AttilaTheHunBruce/Ferd/Balloon Project Plan.odt

# Summary

- I wanted to mate a solar-powered WSPR transmitter with a bunch of helium party balloons (balloon). The idea is to have the balloon report its position and status over WSPR via radio transmission. Amateur radio operators monitor WSPR and report any WSPR transmissions they receive to a central database. I can query the database over the Internet and have a record of the balloon’s progress. I have visions of grandeur and can picture the balloon traveling great distances. Joel suggested the name Magellan. I like that; seems quite appropriate. My wife suggested shortening the name to something a bit more cryptic, so I’m currently referring to the project as Ferd after Ferdinand Magellan.
- Ferd is an attempt to create an inexpensive balloon/payload/antenna system capable of being tracked over long distances. The idea is to use a balloon to carry a transmitter sending out a Weak Signal Propagation Reporter (WSPR) signal. The transmitter is computer controlled and powered by a small solar panel. The antenna is an offcenter-fed antenna hanging from the balloon cluster above the transmitter.
- The transmitter power level will be somewhere between 100 mW – 200 mW. This should be capable of being received thousands of miles away under normal band conditions, so Ferd should be trackable anywhere in the world.
- The total package should weigh less than 3 ounces and cost less than $100 to make, not including the cost of the balloons.
- I want to make the hardware and software opensource. I like the Microsoft Public License (https://opensource.org/license/MS-PL) for software and the TAPR Open Hardware License (https://www.tapr.org/ohl.html) for hardware.
- Ferd should be user-friendly, meaning no surface mount parts and a relatively straightforward programming environment. I’m currently planning on using an Arduino. The Arduino development environment was designed to be as unpainful as practical.
- There are a range of parameters that I’d like to explore. For example, choice of frequency to transmit on, choice of gas to use in the balloon(s), and what altitude to aim for. This will require multiple launches.
- I would like to have units available for sale at Hamvention 2018. The project will have to be presented and approved by the TAPR board meeting at the DCC in September 2017, so the development work and hopefully a flight should be complete by then.
- I intend to use this document as a sort of catchall to record design and operational information so I can find it later.

# Objectives

- I am interested in doing the project for my own enlightenment and to satisfy my curiosity. In addition, I think it would be an interesting and informative project for my friends to take part (not to mention that there’s a lot of work and I can definitely use the help).
- A developed version of Ferd could be marketable by Tuscon Amateur Packet Radio (TAPR). I am a member of TAPR and willing to turn the design over to them for that purpose. TAPR has also offered to cover the cost of materials used in the development effort.
- I can envision schools and groups like scouts being interested in launching and tracking a low cost balloon. I intend to try make the project buildable by people with limited computer and electronic skills, but make no promises as to how low we can go.

73 Bruce Raymond/ND8I

# Design

- WSPR transmitter on 30m
- GPS for location, altitude, and time
- ~200 mW output
- off center-fed antenna
- telemetry: grid square, refinement of grid square, altitude, velocity, temperature, power supply voltage, transmitter output power
- lifted by multiple mylar party balloons;
- cruising altitude of 20,000 ft and stay aloft for several weeks under ideal conditions

## Frequencies

Band (Mtr) | Dial Frequency (MHz) | Lower Band Pass Frequency (MHz) | Upper Band Pass Frequency (MHz) | Band Width (Hz)
33400m | 0.0072 | 0.0087 | 0.0089 | 200
2200m | 0.1360 | 0.1374 | 0.1376 | 200
600m | 0.4742 | 0.4756 | 0.4758 | 200
160m | 1.8366 | 1.8380 | 1.8382 | 200
80m | 3.5926 | 3.5940 | 3.5942 | 200
60m | 5.2872 | 5.2886 | 5.2888 | 200
40m | 7.0386 | 7.0400 | 7.0402 | 200
30m | 10.1387 | 10.1401 | 10.1403 | 200
20m | 14.0956 | 14.0970 | 14.0972 | 200
17m | 18.1046 | 18.1060 | 18.1062 | 200
15m | 21.0946 | 21.0960 | 21.0962 | 200
12m | 24.9246 | 24.9260 | 24.9262 | 200
10m | 28.1246 | 28.1260 | 28.1262 | 200
6m | 50.2930 | 50.2944 | 50.2946 | 200
4m | 70.0910 | 70.0924 | 70.0926 | 200
2m | 144.4885 | 144.4899 | 144.4901 | 200

Channel bandwidth used is 6 Hz and the transmission time is 110.6 sec. The length of a single tone is 0,6827 s and maximum allowed drift is about 1 Hz.

## Antenna Design/Optimization

Ron Thomas and Bill Dionne have made antenna suggestions and calcs that I’d like to acknowledge. Based upon their inputs, The final antenna design is an off-center fed dipole. Well, it’s fed really off center. The overall antenna is 11.065 meters (36’-4”) long with the feed point at 2 meters (6’-7”) from the end, so it’s fed about 1/5 of the way from the end. This means the long leg is 29’-9” long and the short leg is 6’-7” long. The two legs are fed through a common mode choke (FT37-43: 5 turns). There is a 12 uH loading coil between the two legs (across the antenna feed).

This arrangement gives us a resistance of 50 ohms and a inductive reactance of 0.2 ohms for an SWR of 1.0:1. There are a number of combinations of lengths and feedpoint positions that will give us 50 ohms. The 3 dB bandwidth is 244 Khz. The thought was that we could tune out the reactance. What bothered me was that it appears that the tuning is very critical, so if the inductor value is off, the SWR rises quickly. This problem is more acute with higher reactance values (small percentage change in inductance yields a large change in reactance). Consequently, I chose a design that had relatively lower reactance to minimize this effect.

Note that the model/calculation assumes that the balloon is well up in the air so that there aren’t any ground effects affecting the antenna characteristics. The model showed substantially different characteristics when the antenna is closer to the ground (say, 30 ft).

Previous Design

End-fed dipole; FT37-43 toroid 24 turns:3 turns to transform 50 ohms to 3200 ohms

Antenna 44”-9”

Transmission Line 20” RG-174 with plastic outer casing removed

resonant at 10.180 MHz SWR = 1.10:1 Z = 55.3 ohms X = j 0.7 ohms

at 10.140 MHz SWR = 1.13:1 Z = 55.5 ohms X = j 3.4 ohms

### Final Antenna Design

As it turns out, Joel, Ray, and I played with the antenna in Ray’s backyard using Joel’s AA-54 antenna analyzer. The final design ended up being 30’ long, total. The long section is 25’-7”. The short section is 4’3”. This was done with the top of the antenna at about 35’ and the bottom at 5’. We couldn’t go any higher because I couldn’t convince Joel to hand from a rope in the tree at 40’. What a spoil sport. I also got rid of the common mode choke.

## Power/Solar Panel Design

Packaged solar panel vs combining multiple fragile solar cells – pick robust, packaged solar panel

Solar Panel: 6 V/1 W, weight ~23 g, 110 x 60 x 2.5 mm

## Hardware

The hardware consists of a payload and support infrastructure.

### Payload

The payload consists of:

- Main Assembly consists of carriage board, Arduino ProMini/3.3 volt, Adafruit Si5351 oscillator board, uBlox GPS board.
  The LED on the Arduino is on when transmitting.
  Carriage board contains amplifier (BS-170) and seven pole low pass filter, voltage regulator, and MOSFET(s) switch to turn on/off GPS board power.
  A future version of the electronics could be done with surface mount parts and automated assembly. This would simplify soldering part of the kit building to just connecting the three circuit boards plus any components that can’t be surface mount, for whatever reason. This option would require producing a significant quantity of kits to be economically feasible.
- Solar Panel

The solar panel is a monolithic unit with + and – connections on its underside. These connections provide power to the main assembly through a pair of wires. The wires are longer than necessary for a short path connection to help with fatigue resistance from relative movement between the solar panel and the main assembly from vibration and thermal expansion.

- Antenna is offcenter-fed.

### Support Infrastructure

The support infrastructure is the connections between the balloons and the payload along with the internal payload connections (attaching the solar panel to the rest of the payload).

## Software

### Initialization

- Open serial port and second serial port (to talk to GPS).
- Instantiate wspr object for controlling RF chain.
- Setup Timer0 for timing (currently unused).
- Setup Timer1 to count timer overflows.
- Setup the External Interrupt (INT0) to capture the 1 PPS signal from the GPS.
- Initial variables.

### Time Synchronization

The second channel of the TXCO/PLL is configured to generate a 1 MHz signal that is fed into Timer1. Timer1 overflows every 1,000 counts, giving a fairly accurate 1 ms clock interrupt. A counter is incremented inside of the interrupt handler and used to control timing events to within a few milliseconds.

The 1 PPS output from the GPS is connected to the INT0 interrupt. This is used to signal the beginning of a one second interval. This signal is used in conjunction with the time (HH:MM:SS) data from the GPS to accurately set the internal clock/counter.

There is an issue with using the GPS and PLL at the same time. The PLL output appears to swamp the input of the GPS. Also, the GPS draws ~70 mA on startup. There isn’t enough current capacity from the solar panel to drive both the GPS and transmitter simultaneously. Therefore, the PLL (which drives the transmitter) is turned off while the GPS is running and the GPS is turned off while the transmitter is running. The Arduino Pro-Mini internal clock is used to maintain the time during the transition between when the GPS is turned off and the PLL is turned on.

### Telemetry Data

Data are collected from the GPS at the beginning of the cycle. After that the GPS is turned off for the remainder of the cycle, so there is no opportunity to refresh the data during the cycle. Internal measurements (bus voltage and temperature) are made at this time. Transmitter output power can’t be measured yet because the transmitter hasn’t been turned on.

There are four WSPR cycles following turning the GPS off. The first is a regular WSPR transmission (call sign, grid square, power level). The second is a bogus WSPR transmission with the telemetry data formatted into a WSPR message. The callsign starts with the letter Q, making it an invalid callsign so as not to be confused with a legitimate callsign. The third transmission is a repeat of the first and the fourth transmission is a repeat of the second.

After the four WSPR transmissions the GPS is restarted and the process repeats.

The transmitter output is measured ¼ th of the way through the first transmission. ¼ was selected so that the transmitter output could stabilize (if necessary).

The Arduino LED is turned on when transmitting.

### State Machine

- Turn on GPS, wait for GPS lock. (state= StartGPS)
- Calibrate clock, turn GPS off, encode WSPR data. (state = WaitingForSatelliteLock)
- Transmit WSPR message (state = Transmittion1)
- Transmit alternate message (state = Transmittion2)
- Transmit WSPR message (state = Transmittion3)
- Transmit alternate message (state = Transmittion4)

### Power

- Solar panel puts out about roughly 5 volts at 130 mA
- Arduino Pro Mini uses an Atmel ATmega328P processor. Maximum current draw is 9 mA
- Adafruit Si5351 board draws 15 mA
- uBlox GPS module draws 47 mA
- Power amplifier draws 100 mA (5 volts/ 50 ohms)

Two operating states:

- Arduino, Si5351, GPS => 9 mA + 15 mA + 47 mA = 71 mA
- Arduino, Si5351, Power Amplifier => 9 mA + 15 mA + 100 mA = 124 mA

# Testing

## Test Plan/Procedures

## Temperature Testing

Cold soak payload unit to assess how well it works in cold temperatures

Cold soak solar panel and verify that it still works when cold

use dry ice for cold soaking

## Functional Testing

Individual function tests

## Endurance Testing (day/night)

Combined system test – hang solar panel/transmitter/antenna from tree and verify that unit starts up and transmits as expected over a period of several days

## Weight Tradeoffs

I’m always trying to make the payload lighter. There are some practical limits. The balloons weight 0.56 oz/each. The weight of the three circuit boards (Arduino, GPS, PLL) are fixed. I could use a smaller solar panel (I have one that is about 75% the size of my current solar panel), but I’m worried about not having enough power in cloudy conditions. There are probably diminishing returns for much more extensive weight cutting. The payload is currently somewhere around 2 oz.

# Launch

## Balloon Management

Gas selection (hydrogen vs helium)

rent vs buy for regulators and tanks

filling process

filling calculations – design maximum height

what kind of balloons to get

where to get balloons

## Launch Procedures & Checklists

Test port on uC for preflight functional testing (serial communications through microUSB port to a laptop)

## Launch Schedule

# Tracking

Monitoring WSPR site (http://wsprnet.org/drupal/wsprnet/map).

Downloading data.

Interpreting data.

Recording data.

Message Structure:
$GPGGA,hhmmss.ss,Latitude,N,Longitude,E,FS,NoSV,HDOP,msl,m,Altref,m,

DiffAge,DiffStation*cs<CR><LF>
Example:
$GPGGA,092725.00,4717.11399,N,00833.91590,E,1,8,1.01,499.6,M,48.0,M,,0*5B

Field No. | Example | Format | Name | Unit | Description
0 | $GPGGA | string | $GPGGA | - | Message ID, GGA protocol header
1 | 092725.00 | hhmmss.sss | hhmmss. ss | - | UTC Time, Current time
2 | 4717.11399 | ddmm.mmmm | Latitude | - | Latitude, Degrees + minutes, see Format description
3 | N | character | N | - | N/S Indicator, N=north or S=south
4 | 00833.91590 | dddmm. mmmm | Longitud e | - | Longitude, Degrees + minutes, see Format description
5 | E | character | E | - | E/W indicator, E=east or W=west
6 | 1 | digit | FS | - | Position Fix Status Indicator, See Table below and Position Fix Flags description
7 | 8 | numeric | NoSV | - | Satellites Used, Range 0 to 12
8 | 1.01 | numeric | HDOP | - | HDOP, Horizontal Dilution of Precision
9 | 499.6 | numeric | msl | m | MSL Altitude
10 | M | character | uMsl | - | Units, Meters (fixed field)
11 | 48.0 | numeric | Altref | m | Geoid Separation
12 | M | character | uSep | - | Units, Meters (fixed field)
13 | - | numeric | DiffAge | s | Age of Differential Corrections, Blank (Null) fields when DGPS is not used
14 | 0 | numeric | DiffStat ion | - | Diff. Reference Station ID
15 | *5B | hexadecimal | cs | - | Checksum
16 | - | character | <CR><LF> | - | Carriage Return and Line Feed

Message | VTG
Description | Course over ground and Ground speed
Type | Output Message
Comment | Velocity is given as Course over Ground (COG) and Speed over Ground (SOG).
ID for CFG-MSG | Number of fields | Message Info
0xF0 0x05 | 12

Message Structure:
$GPVTG,cogt,T,cogm,M,sog,N,kph,K,mode*cs<CR><LF>
Example:
$GPVTG,77.52,T,,M,0.004,N,0.008,K,A*06

## Telemetry

### Data Encoding

The data stream consists of two WSPR messages. The first is a standard WSPR message with call sign, grid square, and power level (dBm). The second encodes the additional data carries 5th and 6th Maidenhead locator characters, altitude, speed, power bus voltage, temperature, transmitter output power. The second message type will show up in the database as callsigns whose 1st character is "Q" and 3rd character is "5". The other characters and locator and power contain the encoded data, not a valid location.

Telemetry is embedded into the second message. A WSPR data string contains a) call sign, b) grid square, c) power level (dBm). The second message is encoded as follows:

Altitude is encoded as two characters (altitude1 and altitude2). Velocity is encoded as two characters (velocity1 and velocity2). Temperature and bus voltage are stored in one character. Transmitter power (transmitPower) is a single variable spread across two characters in the message.

Second message format is shown below:

### Data Decoding

callsign is made up of 6 characters => c1 c2 c3 c4 c5 c6

gridsquare is made up of 4 characters => g1 g2 g3 g4

power is made up of 2 characters => p1 p2

Alpha characters are converted to numeric values by subtracting 65 (0x40, or A) from the ASCII value, so that A=0, B=1, C=2, etc. Alpha versions of numeric values are are converted to numeric by subtracting 48 (0x30, or 0). This is a straightforward substitution if done manually. Once this is done, the telemetry data are extracted as follows:

altitude = 1750 * g1 + 50 * c2

e.g.: g1=F, c2=R => altitude = 1750 * 5 + 50 * 17 = 9,600 ft

velocity = 10 * g3 + g4

e.g.: g3=5, g4=9 => velocity = 10 * 5 + 9 = 59 Km/hr

temperature = 5 * c4 – 30

e.g.: c4 = D => temperature = 5 * 4 – 30 => temperature = -10 degC

bus voltage = g2 / 4 + 3

e.g.: g2=M => bus voltage = 12 / 4 + 3 => bus voltage = 6.0 volts

power = 10 * p1 + p2 => yields

e.g.: p1=3, p2=7 => power level = 0.16 watts (see below)

The reader is cautioned to take this number with several large grains of salt. There are a lot of factors that can affect the validity of the reading. The telemetry power level should probably only be used as a relative measurement (“Our range just seems to have dropped. I wonder if the transmit power has dropped?”).

### Altitude

From GPS.

### Velocity

From GPS.

### Temperature

I’m using a thermistor I bought from DigiKey years ago. Its parameters are:

B0 = 3,977 ohms, R0 = 10,000 ohms, T0 = 298 degC, NTC

The thermistor is in a voltage divider circuit with an 8,200 ohm resistor feeding it from a 3.3 volt supply. The output of the voltage divider is fed into a 10-bit A/D converter with a 3.3 volt reference. The output from the A/D converter is converted to resistance as follows -

A/D output goes from 0 – 1023 counts: v = A/D counts * (3.3 volts / 1023 counts)

v = R * 3.3 volts / (R + 8,200 ohms) = 3.3 volts / 1023 counts

rearranging

R = 8,200 * A/D / (1023 – A/D)

Converting from resistance (R) into temperature using a rearranged Steinhart-Hart equation is of the form -

T = B0 / ln( R / (R0 * exp( -B0 / T0 ) ) ) = 3977 / ln( R / (10,000 * exp( -3977 / 298 )))

= 3977 / (4.315 + ln( R ))

### Power Supply Voltage

The bus voltage is fed to an A/D converter channel after running through a voltage divider (8.2K for both resistors). The output voltage is V / 2. This is converted into counts (A/D numbers) by multiplying by 1023 (full scale counts) and dividing by 3.3 volts (reference). IOW -

V = (Vbus / 2)

A/D = V * 1023 counts / 3.3 volts => V = A/D * 3.3 / 1023

combining -

Vbus = (2 * V) = 2 * A/D * 3.3 / 1023 = 6.4516E-3 * A/D

I noticed that my voltage reading were low by about 4.1%, so I added a fudge factor/multiplier (1.041) to compensate.

### Solar Cell Calculations

6V/1W solar cell => Voc = 6 volt, Isc = 1W / 6V = 166 mA

Vmp = 0.75 * Voc = 0.75 * 6 = 4.5 volts

Imp = 0.85 * Isc = 0.85 * 166 mA = 141 mA

Maximum power = Vmp * Imp = 4.5 volts * 141 mA = 634 mW

# Other

## TAPR Considerations

What extra needs to be done to make a kit sellable by TAPR?

Who puts the kits together?

Can we have the boards stuffed in China and then the kit builder only attaches the Arduino, PLL, and GPS boards?

# Legal & Regulatory Issues

## FCC Issues – Is transmitting on 30m legal?

It is legal to operate an automatic transmitter on 30m in a digital mode. Part 97.221(b) specifically authorizes an automatically controlled digital station transmitting on the packet/data segment of the 30m band. Part 97.221(c)(1) requires that the station be responding to local or remote control. The on-board microcontroller is our proxy for local control. It monitors conditions and transmitter inputs and shuts down the transmitter if transmitting would be problematic. Note that the final amplifier can only generate 360 mW (V²/2Po) at most.

§97.221 Automatically controlled digital station.

(b) A station may be automatically controlled while transmitting a RTTY or data emission on the 6 m or shorter wavelength bands, and on the 28.120-28.189 MHz, 24.925-24.930 MHz, 21.090-21.100 MHz, 18.105-18.110 MHz, 14.0950-14.0995 MHz, 14.1005-14.112 MHz, 10.140-10.150 MHz, 7.100-7.105 MHz, or 3.585-3.600 MHz segments.

(c) Except for channels specified in §97.303(h), a station may be automatically controlled while transmitting a RTTY or data emission on any other frequency authorized for such emission types provided that:

(1) The station is responding to interrogation by a station under local or remote control;

## FAA Issues

Our payload is under 6 lbs, so technically we do not have to comply with any other parts of Part 101 by virtue of subsection § 101.1(a)(4).

That said, we should notify the FAA/local ATC of our intentions and get guidance as to what notifications (e.g. NOTAMS) are useful.

### Liability

Our/my liability?

TAPR liability?

### Hazard Matrix

Hazard Matrix

How do other balloons and beacons handle this?

What happens if the balloon travels into another country’s air space?

### Hazards

- Line supporting payload breaks. Low probability. We have multiple balloons and supporting tethers so that a failure of one or several balloons or tethers will not cause a catastrophic drop of the payload. The net result of a balloon failure will be a controlled descent. A failure of one or more tethers will also be a controlled descent.
- Balloon/Payload sucked into airplane engine. This is a concern, although the probability of it happening is very low. The mitigation is to notify FAA/ATC of flight plans and issue a NOTAMS. The payload is well under the FAA weight limit for taking precautions (4 oz vs 6 lbs). The smallest weight listed for bird strikes appears to be 0.85 Kg (1.87 lbs), which is at least seven times heavier than the payload (https://www.skybrary.aero/index.php/Aircraft_Certification_for_Bird_Strike_Risk).
- Hydrogen catches fire during or after inflating balloons. The probability of this happening is low as long as proper storage and inflation procedures are followed. We’ll use helium for the initial launches.
- Complaints from owner of launch site. Make sure we have permission to launch from any private property.
- Someone gets injured during launch. Create and follow launch procedures.

# Appendix A – Lift Analysis

# Ideal Gas Law

The basic calculations are formulated around the Ideal Gas Law –

P * V = n * R * T

where -

P = pressure

V = volume

n = number of moles of gas in the balloon

R = universal gas constant

T = absolute temperature

The Ideal Gas Law can be rearranged as follows -

P * V / T = n * R

R and n will remain constant because we’re assuming that there is no leakage from the balloon. Therefore, P * V / T will be constant at any altitude:

P1 * V1 / T1 = P2 * V2 / T2

The starting volume (how much gas we fill the balloon with on the ground) of gas can be derived by rearranging:

V1 = P2 * V2 * T1 / ( P1 * T2 ) (1)

# Conditions

- The airspace between 15,000 ft – 25,000 ft is potentially less used than the airspace below 10,000 ft and above 25,000 ft. This would seem to be a good target range to fly in. I chose 15,000 ft at a target altitude. Actually, this is the altitude where the gas inside of the balloon has expanded to the full volume of the balloon.
- A balloon will stop rising when it reaches equilibrium, IOW when the lift equals the weight supported. For our purposes, I’ll assume that we’re using seven 17” cube balloons (2 ft^3) and our payload is 2.5 oz, not counting the weight of the balloons or the weight of the helium/gas.
- The helium mixture available from balloon stores is 80% helium and 20% air. I’m just going to assume that its density is 31% of air.
  Atmosphere is 80% N2 and 20% O2, so average molecular weight = 80% * 2 * 14 (N2) + 20% * 2 * 16 (O2) = 28.8. Molecular weight of helium = 4. Average weight = 80% * 4 (He) + 20% * 28.8 (air) = 8.96, or 8.96 / 28.8= 31% of the weight of air.

# Balloon

The balloon will be partially filled upon launch, so that as it rises and the air gets thinner it will eventually fill completely at some altitude (fill altitude). I’ve selected the fill altitude as 15,000 ft.

I fit the Standard Air Data to second order polynomials to make interpolation easier. The polynomial coefficients are shown at the end of the section. In particular, the pressure, temperature, and density numbers were arrived at using these polynomials. The values aren’t shown in the Standard Air Data table, but are close to the values at 20,000 ft.

The gas required on the ground is (values taken from standard gas data above) –

- Gas Required

V0 = P19 * V19 * T0 / ( P0 * T19 )

V0 = 8.30 psi * 2 ft^3 * 519 degR / ( 14.7 psi * 465.6 degR ) = 1.26 ft^3

We’re only going to inflate the balloon to 1.26 ft^3 (63%) so that it will be fully inflated at 15,000 ft.

- Lift

The lift of the balloon at max altitude should exactly cancel the weight of the payload. Lift is equal to volume * difference in densities between the outside air and the gas in the balloon. The result is multiplied by the gravitational constant (32.2 ft/sec^2) and 16 oz/lb to convert to ounces.

lift = (7 balloons) * (1.26 ft³) * (23.77 E-4 – 8.96 E-4) * 32.2 * 16 – 4 oz (payload)

lift = 0.3 oz

I want to have multiple balloons for redundancy in case one of them breaks, we’ll have a gentle descent.

- Max Altitude

The max altitude is the point where the lift goes to zero. The balloon is fully inflated at altitude. The density at max altitude is equal to the weight of the gas plus payload all divided by the volume of the balloon.

density = { (8.96 E-4 * 1.26 ft³ * 32.2 * 16) + 4 oz / 5 balloons } / 2 ft³

density = ( 0.52 oz + 0.8 oz ) / (2 ft³ * 32.2 * 16 ) = 12.8 E-4

Rearranging the above formula -

max altitude = 63.78 - 4.37 * 12.8 + 0.0723 * 12.8 * 12.8 = 19,700 ft

(The coefficients 63.78, -4.37, 0.0723 are from the polynomial fit to density data shown below.)

- Balloon Stress
  I’ve treated the balloon as a thin 17” diameter shell. This isn’t really correct, but everything else is a guess, so it’s probably as close as we’re going to reasonably get. The hoop stress is -
    p * r / t = 0.18 psi * ( 17” / 2 ) / 0.001” = 1.7 Ksi

Longitudinal stress is half of that (0.85 Ksi), so the principal stress is sqrt( 1.5² + 0.75² ) = 1.6 Ksi. The tensile strength of mylar is approximately 34 Ksi, so our factor of safety is 21 (34 / 1.6).

# Appendix B - Part 97 Summary (FCC)

§97.1 Basis and purpose.

(6) Automatic control. The use of devices and procedures for control of a station when it is transmitting so that compliance with the FCC Rules is achieved without the control operator being present at a control point.

§97.7 Control operator required.

When transmitting, each amateur station must have a control operator. The control operator must be a person

§97.203 Beacon station.

(d) A beacon may be automatically controlled while it is transmitting on the 28.20-28.30 MHz, 50.06-50.08 MHz, 144.275-144.300 MHz, 222.05-222.06 MHz or 432.300-432.400 MHz segments, or on the 33 cm and shorter wavelength bands.

§97.217 Telemetry.

Telemetry transmitted by an amateur station on or within 50 km of the Earth's surface is not considered to be codes or ciphers intended to obscure the meaning of communications.

§97.221 Automatically controlled digital station.

(b) A station may be automatically controlled while transmitting a RTTY or data emission on the 6 m or shorter wavelength bands, and on the 28.120-28.189 MHz, 24.925-24.930 MHz, 21.090-21.100 MHz, 18.105-18.110 MHz, 14.0950-14.0995 MHz, 14.1005-14.112 MHz, 10.140-10.150 MHz, 7.100-7.105 MHz, or 3.585-3.600 MHz segments.

(c) Except for channels specified in §97.303(h), a station may be automatically controlled while transmitting a RTTY or data emission on any other frequency authorized for such emission types provided that:

(1) The station is responding to interrogation by a station under local or remote control; and

(2) No transmission from the automatically controlled station occupies a bandwidth of more than 500 Hz.

# Appendix C – Part 101 Summary (FAA)

§ 101.1 Applicability.

(a) This part prescribes rules governing the operation in the United States, of the following:

(4) Except as provided for in § 101.7 (https://www.law.cornell.edu/cfr/text/14/101.7), any unmanned free balloon, that -

(i) Carries a payload package that weighs more than four pounds and has a weight/size ratio of more than three ounces per square inch on any surface of the package, determined by dividing the total weight in ounces of the payload package by the area in square inches of its smallest surface;

(ii) Carries a payload package that weighs more than six pounds;

(iii) Carries a payload, of two or more packages, that weighs more than 12 pounds; or

(iv) Uses a rope or other device for suspension of the payload that requires an impact force of more than 50 pounds to separate the suspended payload from the balloon.

# Appendix D – Module Operation

## LEDs

There are several LEDs on the balloon electronics module:

- Arduino power (red)
- Arduino user-controlled (red)
- GPS indicator (red)

Arduino LED:

- Always on when there’s enough power to illuminate it.

GPS LED:

- On when power is on.
- Off when power is off and when GPS is in low power mode.
- Flashes some times (I don’t understand when; may be when the GPS has found some satellites).

User-controlled LED:

- Flashes four times on startup.
- Off while GPS is finding satellites.
- Flashes quickly and intermittently when bus voltage is too low to adequately drive the system.
- Flashes at one second interval after GPS has acquired time and location data, while waiting for the start of a two minute interval.
- On while transmitting.

## Serial Output

There is a serial output that can be used to display the status during preflight checkout.

The programming connector returns serial ASCII data. This looks similar to -

Enabling GPS.

Putting GPS to sleep.

//************************************//

WSPR-Balloon Control Program

copyright (c) Bruce Raymond 2017

software version 0.1 05 Sep 2017

clock: 70180 msec

call sign: ND8I

grid square: EM60bq

dBm: 20

second call sign: QE7Lbq

second grid square: AA00

second dBm: 30

latitude: 30.69 deg

longitude: -87.91 deg

altitude: 207.02 ft

velocity: 0.00 meters/sec

voltage: 2.81 volts

temperature: 28.58 degC

transmit power: 22 dBm (0=startup)

number of sattelites: 4

//************************************//

Symbols:

3 3 0 2 0 0 2 0 3 2 2 2 3 3 3 0 2 0

3 0 2 1 2 1 1 1 1 0 2 0 2 2 2 0 1 0

0 1 0 3 2 2 2 0 2 2 1 2 1 1 2 2 3 3

0 1 2 2 0 1 1 2 3 0 0 0 2 1 1 2 3 0

1 0 1 0 3 0 2 3 0 2 1 0 3 3 2 0 2 1

3 2 3 0 1 0 2 2 3 0 0 2 2 0 1 0 0 1

2 2 3 3 3 0 1 3 2 0 1 3 0 1 0 0 2 1

3 1 2 0 0 2 0 3 2 1 0 2 3 3 0 0 0 0

2 2 2 1 3 2 1 0 3 3 0 0 0 3 1 0 0 0

segment 1

segment 2

segment 3

segment 4

The first message indicates that the electronics have powered up and are going through a startup sequence. After that, the GPS is turned on

- The electronics have powered up and are going through a startup sequence.
- GPS is turned on and is looking for satellites.
- Main display: GPS has found satellites and updated location and time data.
  The display shows GPS data, bus voltage, temperature, and transmitter power. Also shown are the interpretation of the data (WSPR encoding). This last part is likely not of any interest except for debugging the WSPR encoding.
- Segment 1, 2, 3, 4
  The order of operations is -
  - startup
  - find satellites/get GPS data
  - send basic WSPR message (segment 1)
  - send telemetry data (segment 2)
  - send basic WSPR message again (segment 3)
  - send telemetry data again (segment 4)

Balloon Project Program Plan

Copyright (c) Bruce Raymond 2017 27 of 27 Version 0.2
