AttilaTheHunBruce/Ferd/WSPR Balloon.pptx

WSPR Balloon TAPR Kit

Summary
  - Solar-powered WSPR transmitter with a bunch of helium party balloons (Ferd – short for Ferdinand Magellan).
  - Ferd reports its position and status via WSPR radio transmission.
  - Currently weighs 2.5 ounces and costs <$30 in parts.
  - Available for sale at Hamvention 2018.
  - Potential market: TAPR members, hams, makers, schools, groups like scouts.
  - $150 invested so far, $200 to complete project.

## Slide 2

WSPR Balloon TAPR Kit

- Build/Description
  - Telemetry: location, altitude, speed, temperature, solar panel voltage, transmitter output power.
  - Intent is to provide only the electronics and solar panel.
  - Programming interface (~$2 in parts; $20 from Sparkfun) – include, separate kit, forget?
  - Solar-powered, no energy storage, 100 mW power output.
  - Currently designed for through hole parts. Easily redesign for smd parts to minimize *our* packaging labor in addition to size and weight. Very rough estimate is $5-$10/board total for 100 boards. Potentially minimal increase in total cost, but have to buy 100 boards.
- TAPR Cost: <$30 in parts/components for transmitter.
- Additional costs for a user:
  - $15 for balloons
  - $20/helium cylinder (can probably get away with one cylinder, especially with smd version)
  - Magnet wire (36 ft for antenna), fishing line, scale, USB cable to phone/tablet, waterproofing

## Slide 3

WSPR Balloon TAPR Kit

Legal
  - FAA – Part 101.1.a.4:
    - Part 101 does not apply if payload < 6 lbs
    - NOTAM
  - FCC – Part 97.221.b: A station may be automatically controlled while transmitting a RTTY or data emission on the 6 m or shorter wavelength bands, and on the 28.120-28.189 MHz, 24.925-24.930 MHz, 21.090-21.100 MHz, 18.105-18.110 MHz, 14.0950-14.0995 MHz, 14.1005-14.112 MHz, 10.140-10.150 MHz, 7.100-7.105 MHz, or 3.585-3.600 MHz segments.

## Slide 4

WSPR Balloon TAPR Kit

- Schedule:
  - Endurance and cold temperature testing.
  - First flight late September 2017.
  - Second flight November/December(?).
  - SMD design and stuffed boards if we go this way – January 2018?
  - Available for sale at Hamvention 2018.
- What I need:
  - Decision on SMD vs through hole.
  - I’ve spent ~$150 so far. Need another $200 to finish.

## Slide 5

WSPR Balloon TAPR Kit

- Assemblies (as compared to complete kit)
    - Antenna (magnet wire and fishing line)
    - Programmer
    - Solar panel
    - Balloons
